mtlevine0/open-jingle-bells/hardware/merrie-minstrel-choir/merrie-minstrel-choir.jpg

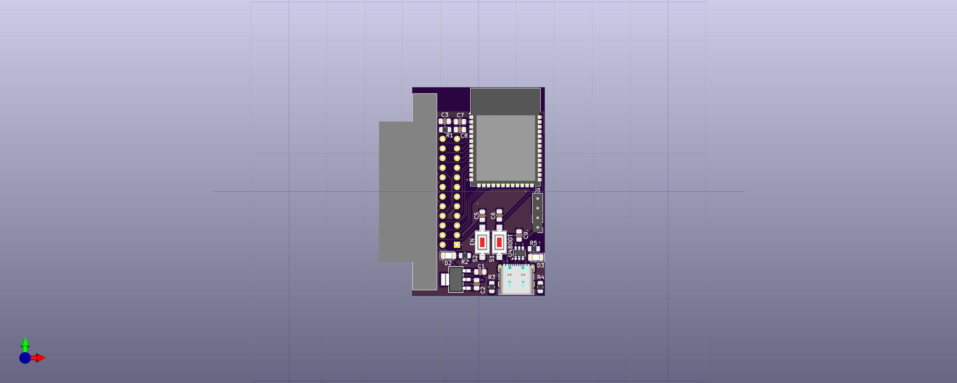
hardware/merrie-minstrel-choir/merrie-minstrel-choir.jpg
