mtlevine0/open-jingle-bells/hardware/merrie-minstrel-choir/merrie-minstrel-choir.stl

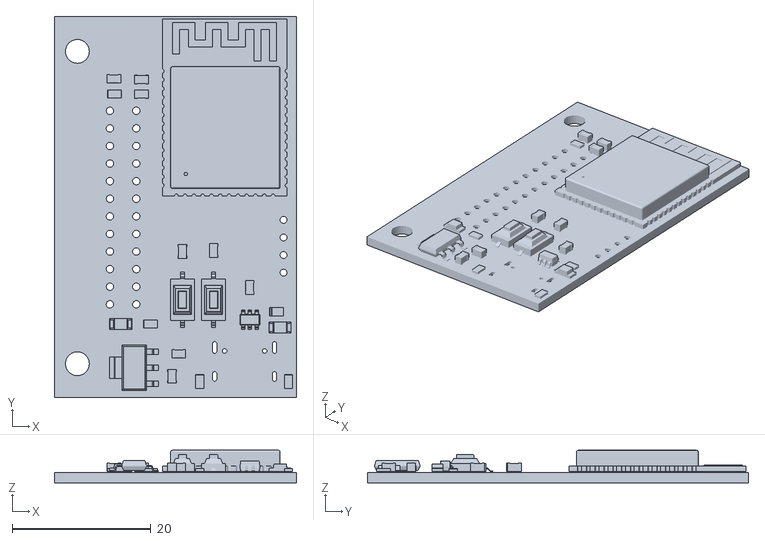
[picture p4: CAD file, 2026-01-22]
hardware/merrie-minstrel-choir/merrie-minstrel-choir.stl
35.0 x 55.0 x 4.70
