mtlevine0/open-jingle-bells/hardware/open-jingle-bells-module/open-jingle-bells-module.kicad_pcb

## KiCad design hardware/open-jingle-bells-module/open-jingle-bells-module.kicad_pcb (2026-10-22)

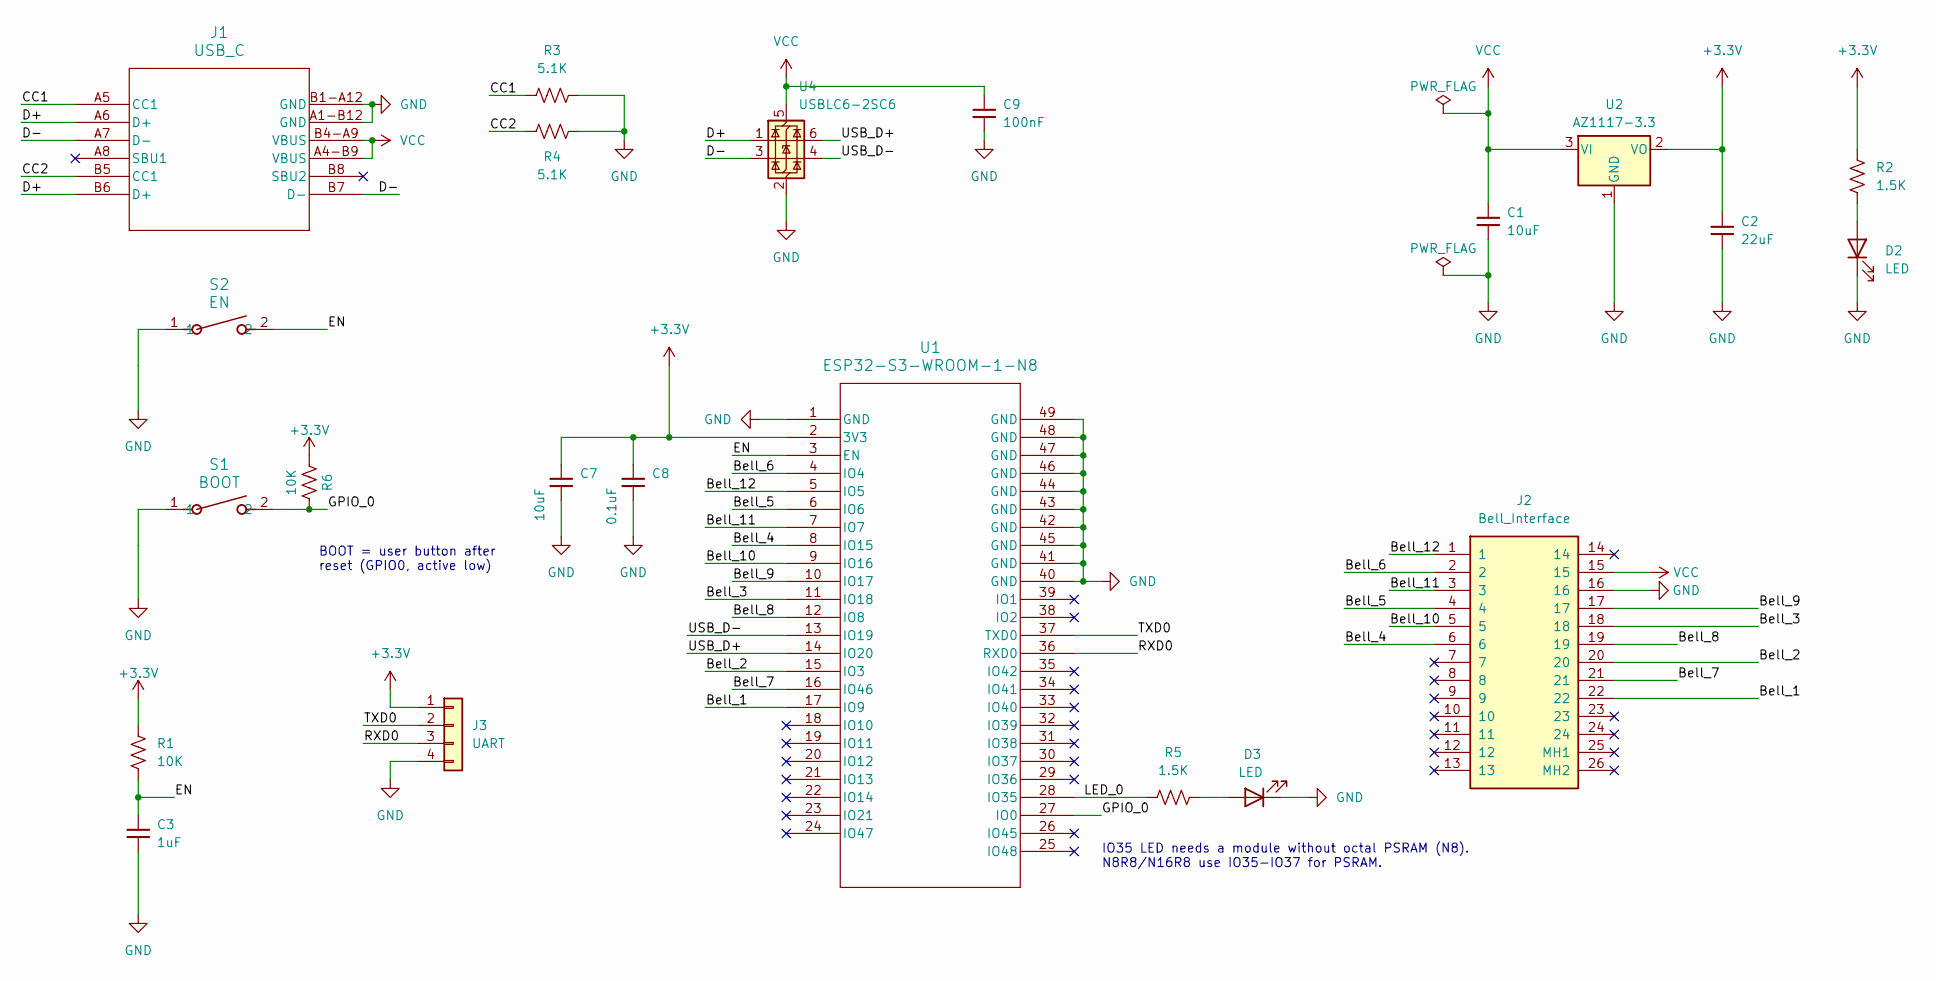
[picture p5: schematic open-jingle-bells-module.kicad_sch, ojb-reciever]

Parts:
C1, C7: 10uF; C_0805_2012Metric_Pad1.18x1.45mm_HandSolder
C2: 22uF; C_0805_2012Metric_Pad1.18x1.45mm_HandSolder
C3: 1uF; C_0805_2012Metric_Pad1.18x1.45mm_HandSolder
C8: 0.1uF; C_0805_2012Metric_Pad1.18x1.45mm_HandSolder
C9: 100nF; C_0805_2012Metric_Pad1.18x1.45mm_HandSolder
D2, D3: LED; LED_0805_2012Metric_Pad1.15x1.40mm_HandSolder
J1: USB_C; 12402012E212A_AMP
J2: Bell_Interface; card_edge_395024559212_noMH; Manufacturer_Part_Number 395-024-559-212
J3: UART; PinHeader_1x04_P2.54mm_Vertical
R1, R6: 10K; R_0603_1608Metric_Pad0.98x0.95mm_HandSolder
R2, R5: 1.5K; R_0603_1608Metric_Pad0.98x0.95mm_HandSolder
R3, R4: 5.1K; R_0603_1608Metric_Pad0.98x0.95mm_HandSolder
S1: BOOT; SW_SPST_TS-1088-xR020; Manufacturer_Part_Number TS-1088-AR02016
S2: EN; SW_SPST_TS-1088-xR020; Manufacturer_Part_Number TS-1088-AR02016
U1: ESP32-S3-WROOM-1-N8; ESP32-S3-WROOM-1
U2: AZ1117-3.3; SOT-223_DIO
U4: USBLC6-2SC6; SOT-23-6

Connections:
+3.3V: C2.1, C7.1, C8.1, J3.1, R1.1, R2.1, R6.1, U1.2 (3V3), U2.2 (VO)
/Bell_1: J2.22, U1.17 (IO9)
/Bell_2: J2.20, U1.15 (IO3)
/Bell_3: J2.18, U1.11 (IO18)
/Bell_4: J2.6, U1.8 (IO15)
/Bell_5: J2.4, U1.6 (IO6)
/Bell_6: J2.2, U1.4 (IO4)
/Bell_7: J2.21, U1.16 (IO46)
/Bell_8: J2.19, U1.12 (IO8)
/Bell_9: J2.17, U1.10 (IO17)
/Bell_10: J2.5, U1.9 (IO16)
/Bell_11: J2.3, U1.7 (IO7)
/Bell_12: J2.1, U1.5 (IO5)
/CC1: J1.A5 (CC1), R3.1
/CC2: J1.B5 (CC1), R4.1
/D+: J1.A6 (D+), J1.B6 (D+), U4.1 (I/O1)
/D-: J1.A7 (D-), J1.B7 (D-), U4.3 (I/O2)
/EN: C3.1, R1.2, S2.2, U1.3 (EN)
/GPIO_0: R6.2, S1.2, U1.27 (IO0)
/LED_0: R5.1, U1.28 (IO35)
/RXD0: J3.3, U1.36 (RXD0)
/TXD0: J3.2, U1.37 (TXD0)
/USB_D+: U1.14 (IO20), U4.6 (I/O1)
/USB_D-: U1.13 (IO19), U4.4 (I/O2)
GND: C1.2, C2.2, C3.2, C7.2, C8.2, C9.1, D2.1 (K), D3.1 (K), J1.A1-B12 (GND), J1.B1-A12 (GND), J2.16, J3.4, R3.2, R4.2, S1.1, S2.1, U1.1 (GND), U1.40 (GND), U1.41 (GND), U1.42 (GND), U1.43 (GND), U1.44 (GND), U1.45 (GND), U1.46 (GND), U1.47 (GND), U1.48 (GND), U1.49 (GND), U2.1 (GND), U4.2 (GND)
unnamed: D2.2 (A), R2.2
unnamed: D3.2 (A), R5.2
VCC: C1.1, C9.2, J1.A4-B9 (VBUS), J1.B4-A9 (VBUS), J2.15, U2.3 (VI), U4.5 (VBUS)

Notes on the sheet:
IO35 LED needs a module without octal PSRAM (N8). N8R8/N16R8 use IO35-IO37 for PSRAM.
BOOT = user button after reset (GPIO0, active low)

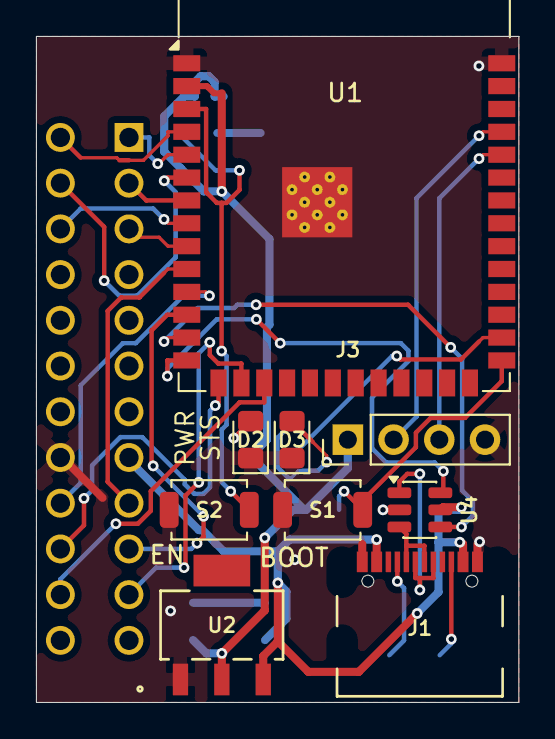
[picture p6: board open-jingle-bells-module.kicad_pcb from above]

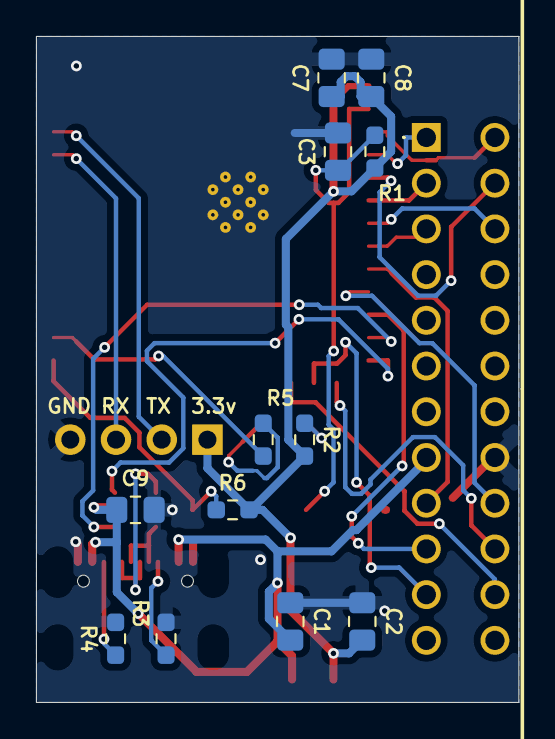
[picture p7: board open-jingle-bells-module.kicad_pcb from below]

Board: 2 copper layers, 26.8 x 37.0 mm, 22 parts (13 on the bottom side), 28 nets.
