mtlevine0/open-jingle-bells/hardware/merrie-minstrel-player/merrie-minstrel-player.kicad_pcb

## KiCad design hardware/merrie-minstrel-player/merrie-minstrel-player.kicad_pcb (2026-10-12)

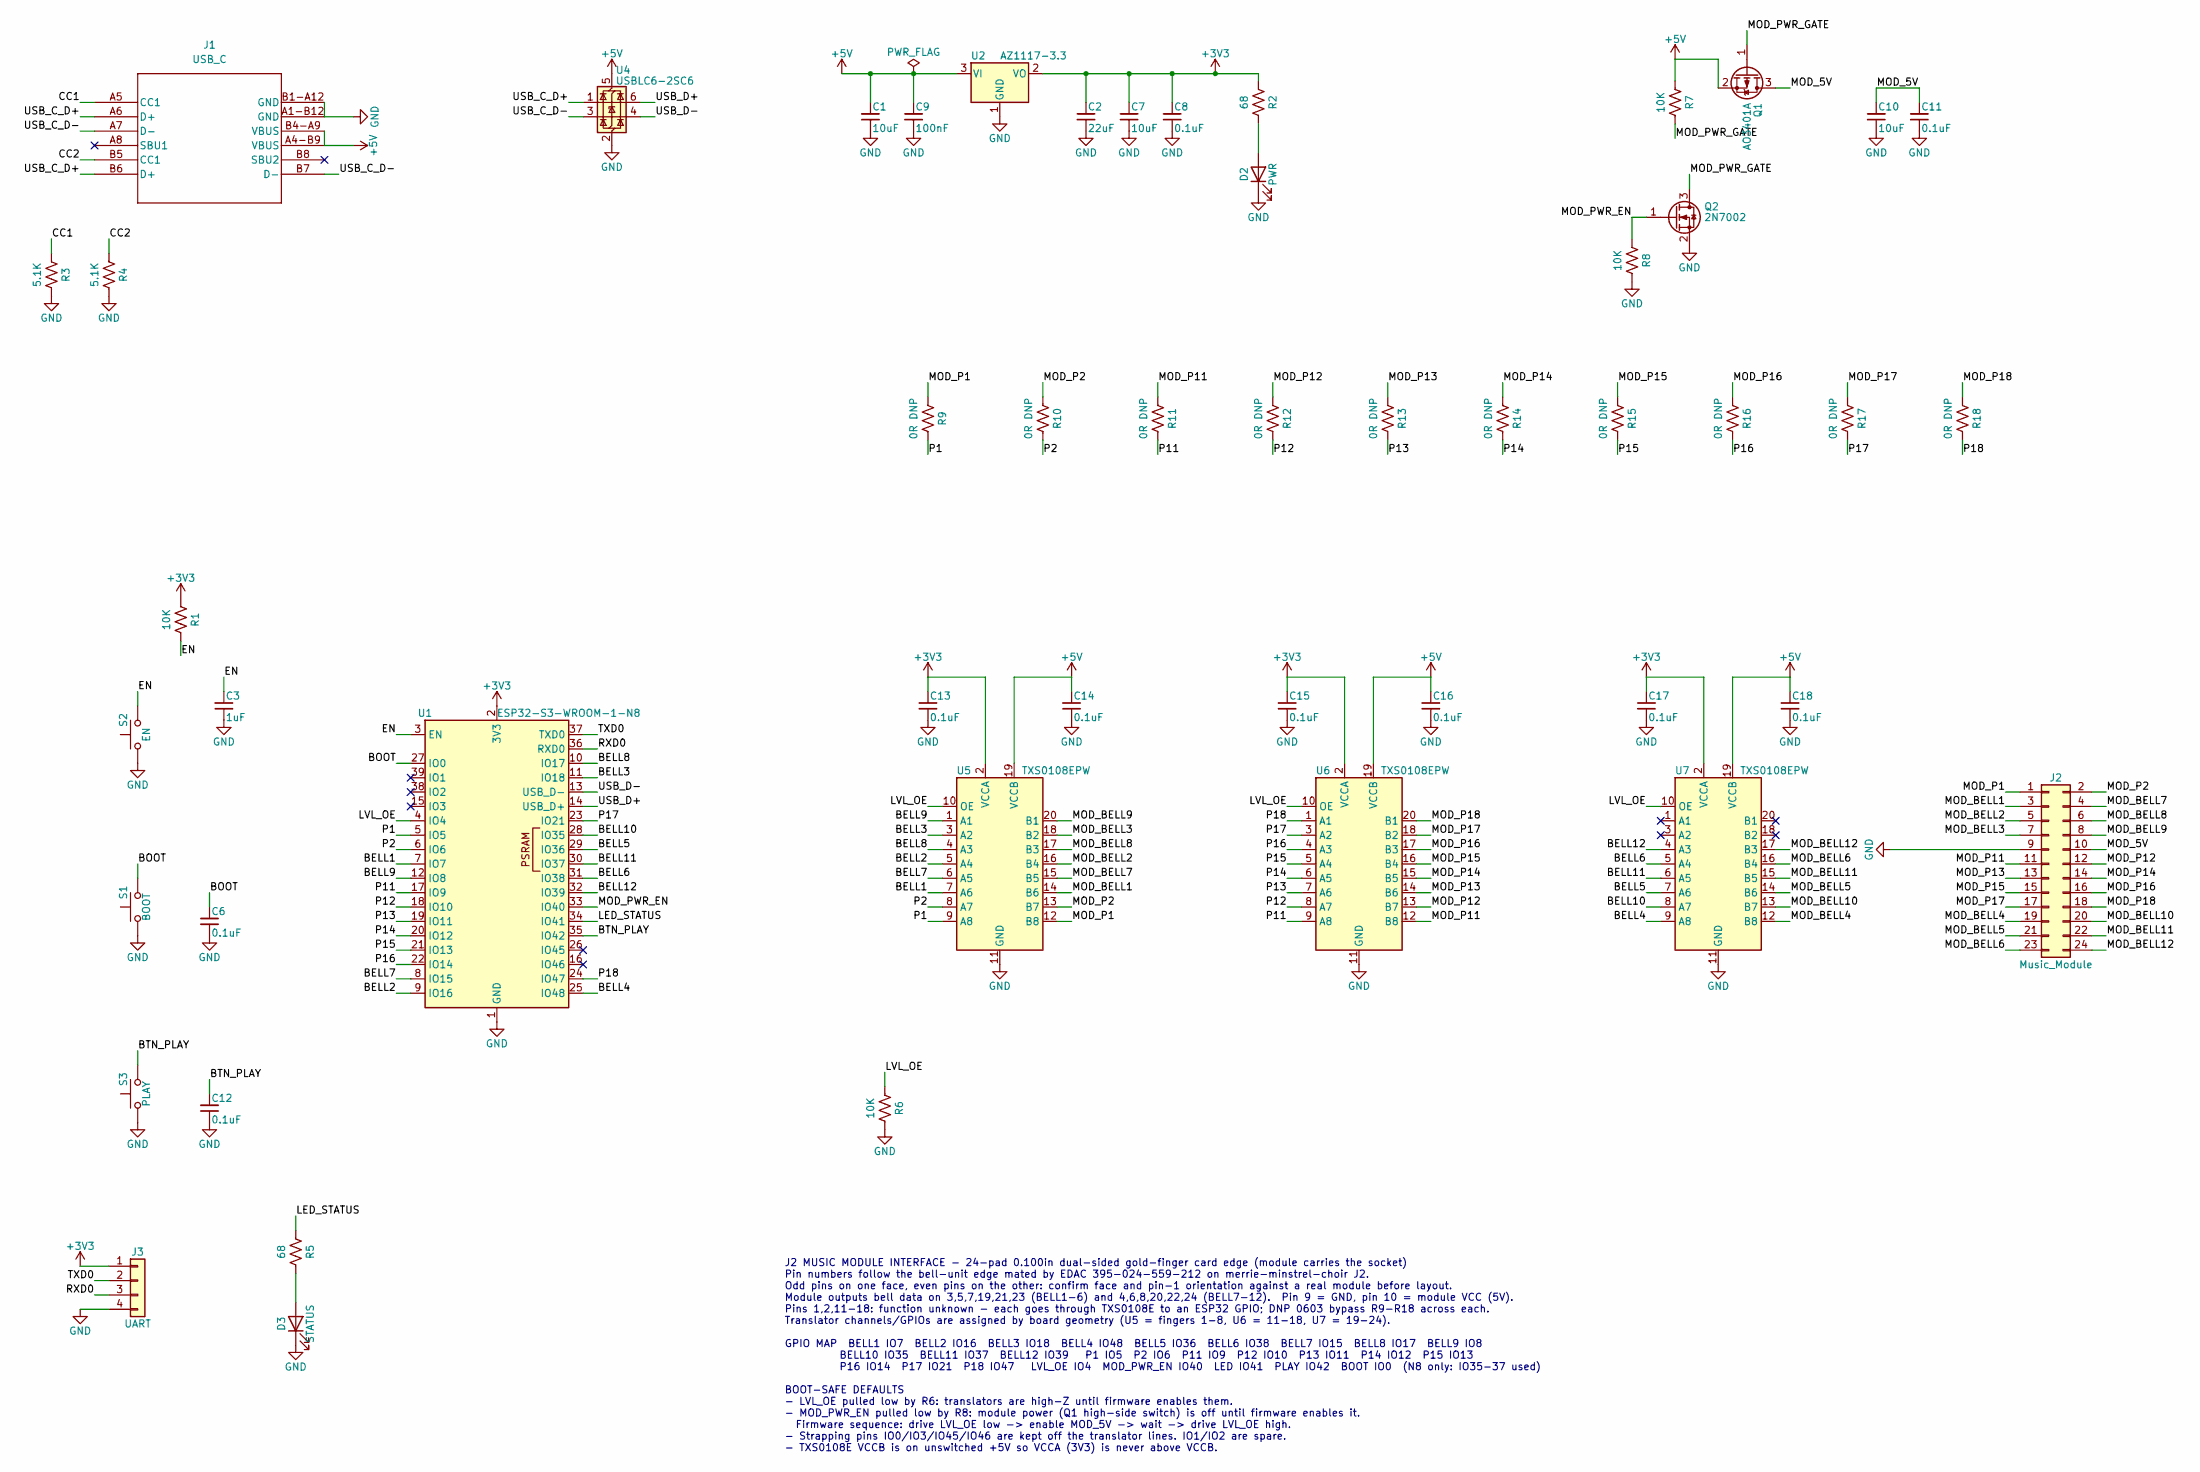
[picture p8: schematic merrie-minstrel-player.kicad_sch]

Parts:
C1, C7, C10: 10uF; C_0805_2012Metric_Pad1.18x1.45mm_HandSolder
C2: 22uF; C_0805_2012Metric_Pad1.18x1.45mm_HandSolder
C3: 1uF; C_0805_2012Metric_Pad1.18x1.45mm_HandSolder
C6, C8, C11, C12, C13, C14, C15, C16, C17, C18: 0.1uF; C_0805_2012Metric_Pad1.18x1.45mm_HandSolder
C9: 100nF; C_0805_2012Metric_Pad1.18x1.45mm_HandSolder
D2: PWR; LED_1206_3216Metric
D3: STATUS; LED_1206_3216Metric
J1: USB_C; 12402012E212A_AMP
J2: Music_Module; CardEdge_2x12_P2.54mm_GoldFinger
J3: UART; PinHeader_1x04_P2.54mm_Vertical
Q1: AO3401A; SOT-23
Q2: 2N7002; SOT-23
R1, R6, R7, R8: 10K; R_0805_2012Metric_Pad1.20x1.40mm_HandSolder
R2, R5: 68; R_0805_2012Metric_Pad1.20x1.40mm_HandSolder
R3, R4: 5.1K; R_0805_2012Metric_Pad1.20x1.40mm_HandSolder
R9, R10, R11, R12, R13, R14, R15, R16, R17, R18: 0R DNP; R_0603_1608Metric_Pad0.98x0.95mm_HandSolder
S1: BOOT; SW_SPST_CK_RS282G05A3
S2: EN; SW_SPST_CK_RS282G05A3
S3: PLAY; SW_SPST_CK_RS282G05A3
U1: ESP32-S3-WROOM-1-N8; ESP32-S3-WROOM-1
U2: AZ1117-3.3; SOT-223_DIO
U4: USBLC6-2SC6; SOT-23-6
U5, U6, U7: TXS0108EPW; TSSOP-20_4.4x6.5mm_P0.65mm

Connections:
+3V3: C2.1, C7.1, C8.1, C13.1, C15.1, C17.1, J3.1, R1.1, R2.1, U1.2 (3V3), U2.2 (VO), U5.2 (VCCA), U6.2 (VCCA), U7.2 (VCCA)
+5V: C1.1, C9.1, C14.1, C16.1, C18.1, J1.A4-B9 (VBUS), J1.B4-A9 (VBUS), Q1.2 (S), R7.1, U2.3 (VI), U4.5 (VBUS), U5.19 (VCCB), U6.19 (VCCB), U7.19 (VCCB)
/BELL1: U1.7 (IO7), U5.7 (A6)
/BELL2: U1.9 (IO16), U5.5 (A4)
/BELL3: U1.11 (IO18), U5.3 (A2)
/BELL4: U1.25 (IO48), U7.9 (A8)
/BELL5: U1.29 (IO36), U7.7 (A6)
/BELL6: U1.31 (IO38), U7.5 (A4)
/BELL7: U1.8 (IO15), U5.6 (A5)
/BELL8: U1.10 (IO17), U5.4 (A3)
/BELL9: U1.12 (IO8), U5.1 (A1)
/BELL10: U1.28 (IO35), U7.8 (A7)
/BELL11: U1.30 (IO37), U7.6 (A5)
/BELL12: U1.32 (IO39), U7.4 (A3)
/BOOT: C6.1, S1.2, U1.27 (IO0)
/BTN_PLAY: C12.1, S3.2, U1.35 (IO42)
/CC1: J1.A5 (CC1), R3.1
/CC2: J1.B5 (CC1), R4.1
/EN: C3.1, R1.2, S2.2, U1.3 (EN)
/LED_STATUS: R5.1, U1.34 (IO41)
/LVL_OE: R6.1, U1.4 (IO4), U5.10 (OE), U6.10 (OE), U7.10 (OE)
/MOD_5V: C10.1, C11.1, J2.10, Q1.3 (D)
/MOD_BELL1: J2.3, U5.14 (B6)
/MOD_BELL2: J2.5, U5.16 (B4)
/MOD_BELL3: J2.7, U5.18 (B2)
/MOD_BELL4: J2.19, U7.12 (B8)
/MOD_BELL5: J2.21, U7.14 (B6)
/MOD_BELL6: J2.23, U7.16 (B4)
/MOD_BELL7: J2.4, U5.15 (B5)
/MOD_BELL8: J2.6, U5.17 (B3)
/MOD_BELL9: J2.8, U5.20 (B1)
/MOD_BELL10: J2.20, U7.13 (B7)
/MOD_BELL11: J2.22, U7.15 (B5)
/MOD_BELL12: J2.24, U7.17 (B3)
/MOD_P1: J2.1, R9.1, U5.12 (B8)
/MOD_P2: J2.2, R10.1, U5.13 (B7)
/MOD_P11: J2.11, R11.1, U6.12 (B8)
/MOD_P12: J2.12, R12.1, U6.13 (B7)
/MOD_P13: J2.13, R13.1, U6.14 (B6)
/MOD_P14: J2.14, R14.1, U6.15 (B5)
/MOD_P15: J2.15, R15.1, U6.16 (B4)
/MOD_P16: J2.16, R16.1, U6.17 (B3)
/MOD_P17: J2.17, R17.1, U6.18 (B2)
/MOD_P18: J2.18, R18.1, U6.20 (B1)
/MOD_PWR_EN: Q2.1 (G), R8.1, U1.33 (IO40)
/MOD_PWR_GATE: Q1.1 (G), Q2.3 (D), R7.2
/P1: R9.2, U1.5 (IO5), U5.9 (A8)
/P2: R10.2, U1.6 (IO6), U5.8 (A7)
/P11: R11.2, U1.17 (IO9), U6.9 (A8)
/P12: R12.2, U1.18 (IO10), U6.8 (A7)
/P13: R13.2, U1.19 (IO11), U6.7 (A6)
/P14: R14.2, U1.20 (IO12), U6.6 (A5)
/P15: R15.2, U1.21 (IO13), U6.5 (A4)
/P16: R16.2, U1.22 (IO14), U6.4 (A3)
/P17: R17.2, U1.23 (IO21), U6.3 (A2)
/P18: R18.2, U1.24 (IO47), U6.1 (A1)
/RXD0: J3.3, U1.36 (RXD0)
/TXD0: J3.2, U1.37 (TXD0)
/USB_C_D+: J1.A6 (D+), J1.B6 (D+), U4.1 (I/O1)
/USB_C_D-: J1.A7 (D-), J1.B7 (D-), U4.3 (I/O2)
/USB_D+: U1.14 (USB_D+), U4.6 (I/O1)
/USB_D-: U1.13 (USB_D-), U4.4 (I/O2)
GND: C1.2, C2.2, C3.2, C6.2, C7.2, C8.2, C9.2, C10.2, C11.2, C12.2, C13.2, C14.2, C15.2, C16.2, C17.2, C18.2, D2.1 (K), D3.1 (K), J1.A1-B12 (GND), J1.B1-A12 (GND), J2.9, J3.4, Q2.2 (S), R3.2, R4.2, R6.2, R8.2, S1.1, S2.1, S3.1, U1.1 (GND), U1.40 (GND), U1.41 (GND), U2.1 (GND), U4.2 (GND), U5.11 (GND), U6.11 (GND), U7.11 (GND)
unnamed: D2.2 (A), R2.2
unnamed: D3.2 (A), R5.2

Notes on the sheet:
J2 MUSIC MODULE INTERFACE - 24-pad 0.100in dual-sided gold-finger card edge (module carries the socket) Pin numbers follow the bell-unit edge mated by EDAC 395-024-559-212 on merrie-minstrel-choir J2. Odd pins on one face, even pins on the other: confirm face and pin-1 orientation against a real mo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

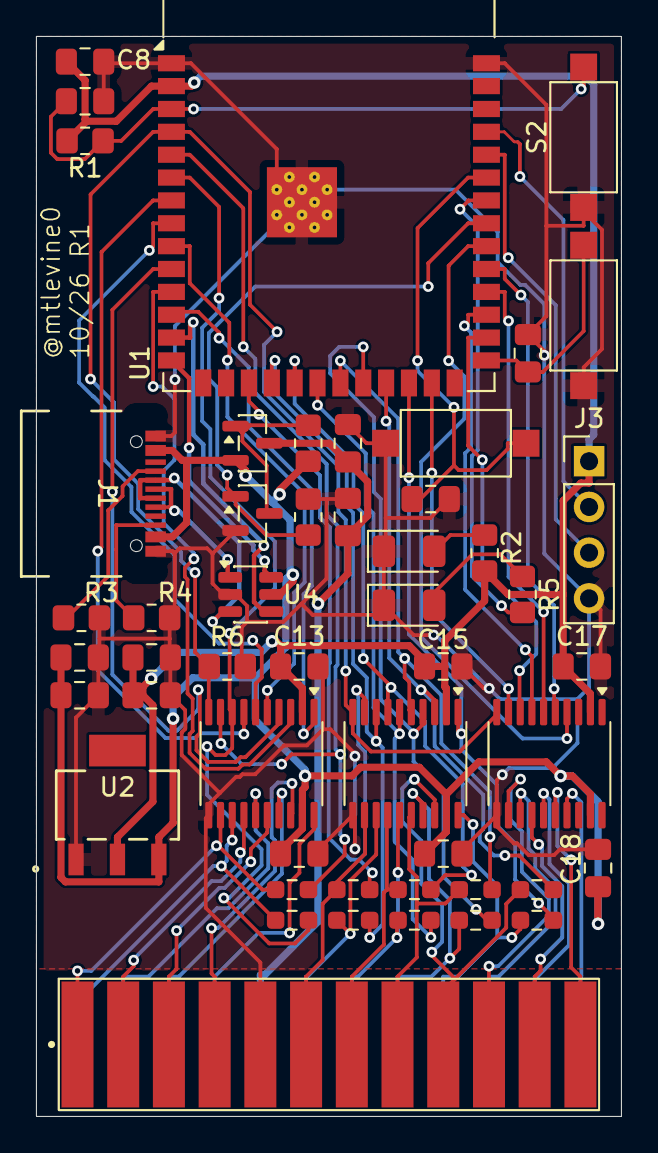
[picture p9: board merrie-minstrel-player.kicad_pcb from above]

Board: 2 copper layers, 32.5 x 60.0 mm, 50 parts (0 on the bottom side), 65 nets.
