mtlevine0/open-jingle-bells/firmware/transmitter/transmitter.ino

  #include <esp_now.h>
#include <WiFi.h>
#include <esp_wifi.h>

const uint16_t romData[] = {
  #include "rom_dump_hex.h"
};
const size_t ROM_SIZE = sizeof(romData) / sizeof(romData[0]);
uint8_t channel = 6; 

uint8_t broadcastAddress[] = {0xFF, 0xFF, 0xFF, 0xFF, 0xFF, 0xFF};

typedef struct struct_message {
  uint16_t noteByte;
} struct_message;

struct_message myData;

esp_now_peer_info_t peerInfo;

// callback when data is sent
void OnDataSent(const uint8_t *mac_addr, esp_now_send_status_t status) {
  Serial.print("\r\nLast Packet Send Status:\t");
  Serial.println(status == ESP_NOW_SEND_SUCCESS ? "Delivery Success" : "Delivery Fail");
}
 
void setup() {
  Serial.begin(115200);
  WiFi.mode(WIFI_MODE_STA);  

  if (esp_now_init() != ESP_OK) {
    Serial.println("Error initializing ESP-NOW");
    return;
  }

  esp_wifi_set_protocol(WIFI_IF_STA, WIFI_PROTOCOL_LR);
  esp_wifi_set_channel(channel, WIFI_SECOND_CHAN_NONE);
  esp_now_register_send_cb(OnDataSent);
  
  memcpy(peerInfo.peer_addr, broadcastAddress, 6);
  peerInfo.channel = 0;  
  peerInfo.encrypt = false;
  
  if (esp_now_add_peer(&peerInfo) != ESP_OK){
    Serial.println("Failed to add peer");
    return;
  }
}
 
volatile size_t romIndex = 0;

void loop() {
  myData.noteByte = romData[romIndex];

  esp_err_t result = esp_now_send(broadcastAddress, (uint8_t *) &myData, sizeof(myData));
   
  if (result == ESP_OK) {
    Serial.println("Sent with success");
  }
  else {
    Serial.println("Error sending the data");
  }
  delay(200);
  romIndex++;
  if (romIndex >= ROM_SIZE)
    romIndex = 0;
}
