mtlevine0/open-jingle-bells/firmware/json.h

#pragma once
#include <Arduino.h>

// Quoted, escaped JSON string.
inline String jsonString(const String &s) {
  String out = "\"";
  for (size_t i = 0; i < s.length(); i++) {
    char c = s[i];
    if (c == '"' || c == '\\') {
      out += '\\';
      out += c;
    } else if ((uint8_t)c < 0x20) {
      char buf[8];
      snprintf(buf, sizeof(buf), "\\u%04x", c);
      out += buf;
    } else {
      out += c;
    }
  }
  out += '"';
  return out;
}
