mtlevine0/open-jingle-bells/(commit log)

2026-10-12 Add merrie-minstrel-player board with silkscreen cleanup
    ESP32-S3 music-module player: schematic, 32.5 x 60 mm 2-layer board
    (fully routed via Freerouting), gold-finger card-edge footprint, and a
    pre-order TODO.
    Silkscreen cleanup clears all 86 silk overlap / silk-over-copper DRC
    warnings. Uncrowded references sit next to their parts on F.SilkS.
    Crowded ones (R9-R18, the module-power cluster, USB/LDO caps, level
    shifters, LEDs and switches) are mirrored on B.SilkS under their parts.
    J2's reference and J1's pin markers are moved to F.Fab. The 5 remaining
    silk-edge warnings come from footprint artwork overhanging the edge by
    design.
2026-10-20 Replace receiver firmware with player (ESP-NOW + USB serial)
    The player firmware strikes bells from the transmitter's ESP-NOW packets,
    as the receiver did, and also from line commands over the native USB
    serial port (strike, note, pulse, notes, status, help). The default pin
    map matches the merrie-minstrel-choir board. Build with -DPLAYER_BOARD
    for the merrie-minstrel-player board.
    play_scale.py replays the ROM intro scale over USB as a check.
2026-10-20 Add bell pinout CSV and name player notes C6-E7
    bell_pinout.csv replaces the bell_pintout2 spreadsheet. Each bell's note,
    ROM bit, edge pin and choir/player GPIO are checked against player.ino,
    the ROM intro scale and both board layouts. .gitignore gets an exception
    so the KiCad BOM rule (*.csv) doesn't hide it.
    The player's note command now uses the C6-E7 names the sheet and the MIDI
    tools use, and accepts Bb6/Gb6 as aliases.
2026-10-21 Choir board rev 2: fix EN pull-up, bottom-mount J2, shrink outline
    - EN: R1 now pulls EN to +3.3V and C3 sits from EN to GND (rev 1 had
    R1 and C3 in series to GND with no pull-up).
    - J2 card-edge socket moved to the bottom side in the same slot
    position. The upside-down socket maps card finger n to pin 25-n, so the
    schematic is re-pinned and every bell still reaches the same GPIO.
    - Outline 33.5 x 53 mm (was 35 x 55), inside the rev 1 outline, with
    USB-C and the J2 mounting holes unmoved.
    - Re-routed with Freerouting; GND trace cleanup guarded by DRC.
    Scripts and the DSN/SES job are in route/.
2026-10-21 Choir rev 2: 0805 LEDs, 0603 resistors, J2 at the board edge
    - D2/D3 to LED_0805, R1-R5 to R_0603 (hand-solder pads).
    - J2 footprint without its mounting holes (card_edge_395024559212_noMH);
    the socket ears hang off the board, so the left edge moves in to
    0.5 mm outside the outer pin row. Board is now 26.8 x 53 mm.
    - EN cap C3 moves next to C5; R1/C7/C8 sit in a row above J2.
    - Re-routed and GND traces trimmed under DRC guard.
2026-10-21 Choir rev 2: route USB as a coupled pair, top edge at the antenna
    - ESD (U4) to ESP32 USB runs as a locked B.Cu pair, 0.3 mm / 0.2 mm gap,
    1.1 mm skew; J1 to U4 kept as short as the receptacle pinout allows.
    - Board top edge moves to y 61 (antenna overhangs), from the edit made
    in KiCad. R1 moves next to C5/C3 so the 3V3 caps' labels fit.
    - import_ses.py drops zero-length stubs and widens tracks necked below
    0.1524 mm; usb_pair.py added to the route pipeline.
2026-10-21 Choir rev 2: R/C to the back, shrink to 26.8 x 37 mm, schematic fixes
    Layout:
    - Every resistor and capacitor moves to the back, behind the part it serves.
    - The board shrinks to 26.8 x 37 mm. J1 moves up 10 mm, so the enclosure's
    USB-C opening has to move too.
    - The J1/U4/C9 corner is hand-routed and locked; the rest is re-routed with
    Freerouting, and the redundant GND traces are removed.
    - Silkscreen references are re-placed at the 0.8 mm minimum.
    - New scripts: route/v3_layout.py, usb_v3.py, silk_v3.py.
    Schematic:
    - Adds R6, a 10k pull-up on GPIO0. BOOT stays, for serial flashing and as a
    user button.
    - Removes the button caps C5 and C6.
    - R2/R5 are now 1.5k, so the LEDs glow dimly.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
2026-10-22 Replace the ESP-NOW player/transmitter with the minstrel firmware
    The sketch in firmware/ (firmware.ino) runs on every bell unit and plays a
    compiled-in song library instead of following a transmitter's stream:
    - Playback on its own core-1 task, timed to the microsecond, with once,
    repeat and play-all modes.
    - Wi-Fi setup through a captive-portal access point, then a control page
    (play, songs, bell test, health, setup) and a JSON API.
    - Group sync over UDP on the LAN: units keep a shared clock with the
    lowest-MAC unit, and whoever is pressed conducts by broadcasting a
    scheduled song timeline, so every unit strikes the same frame together.
    - The USB serial commands of the old player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
2026-10-22 Rename the project to Open Jingle Bells
    The KiCad projects become open-jingle-bells-choir and
    open-jingle-bells-player, the tools package becomes
    open-jingle-bells-tools with ojb-* commands, and the firmware's page,
    setup AP (JingleBells-XXXX) and default host name take the new name.
    The NVS namespace stays "minstrel" so flashed units keep their settings.
2026-10-22 Remove the player board from main
    It is parked on the player-board-wip branch with its work in progress
    layout and STEP export. The firmware keeps its PLAYER_BOARD build.
2026-10-22 Rename the choir board to open-jingle-bells-module
    The KiCad project, its files and the firmware's BOARD_NAME take the
    new name.
